matankaplyan-byte/MacroPad/macropad/macro_pad_BOM.csv

Reference | Value | Footprint | Exclude from Board | Exclude from Simulation | Qty | LCSC
C1 | 1uF | Capacitor_SMD:C_0603_1608Metric |  |  | 1 | C113807
C2,C3 | 1uF | C_0603_1608Metric |  |  | 2 | C113807
C4,C5,C6,C7,C8 | 100nf | C_0603_1608Metric |  |  | 5 | C49326605
C9,C10 | 33pF | C_0603_1608Metric |  |  | 2 | C107047
C11 | 100nF | C_0603_1608Metric |  |  | 1 | C49326605
J1 | USB_C_Receptacle_USB2.0_16P | Connector_USB:USB_C_Receptacle_HRO_TYPE-C-31-M-12 |  |  | 1 | C165948
J2 | Conn_01x07_Pin | Connector_PinHeader_2.54mm:PinHeader_1x07_P2.54mm_Vertical | Excluded from board |  | 1
R2,R3 | 5.1k | Resistor_SMD:R_0603_1608Metric |  |  | 2 | C23186
R4,R5 | 27Ω | Resistor_SMD:R_0603_1608Metric |  |  | 2 | C25190
R6,R7 | 10kΩ | Resistor_SMD:R_0603_1608Metric |  |  | 2 | C25804
SW1,SW4,SW5,SW6,SW7,SW8 | SW_Push | Button_Switch_Keyboard:SW_Cherry_MX_1.00u_PCB | Excluded from board |  | 6
SW2,SW3 | SW_Push | SW_SPST_TL3342 |  |  | 2 | C2886897
SW9 | RotaryEncoder_Switch | Rotary_Encoder:RotaryEncoder_Alps_EC11E-Switch_Vertical_H20mm |  |  | 1
U1 | RP2040 | Package_DFN_QFN:QFN-56-1EP_7x7mm_P0.4mm_EP3.2x3.2mm |  |  | 1 | C2040
U2 | AP2112K-3.3 | Package_TO_SOT_SMD:SOT-23-5 |  |  | 1 | C51118
U3 | GD25Q32ESIGR | Package_SO:SOIC-8_5.3x5.3mm_P1.27mm |  |  | 1 | C2832998
Y1 | 12MHz | Crystal:Crystal_SMD_3225-4Pin_3.2x2.5mm |  |  | 1 | C9002
