matankaplyan-byte/MacroPad/macropad/Top.step

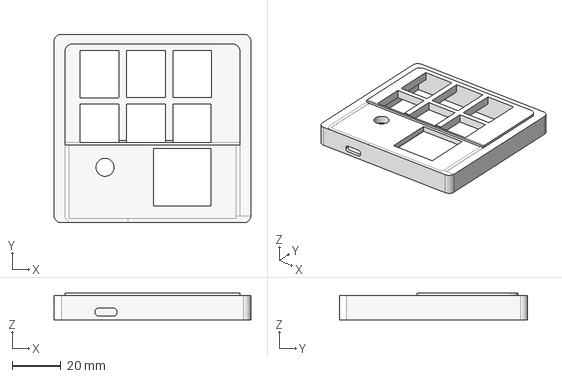
[picture p1: CAD file, 2026-11-11]
macropad/Top.step
80.7 x 77.2 x 11.0 mm
