matankaplyan-byte/MacroPad/macropad/Bottom.step

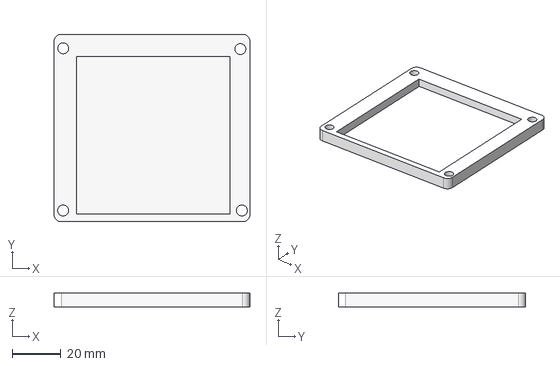
[picture p2: CAD file, 2026-11-11]
macropad/Bottom.step
80.7 x 77.2 x 5.80 mm
