matankaplyan-byte/MacroPad/macropad/macropadV3.step

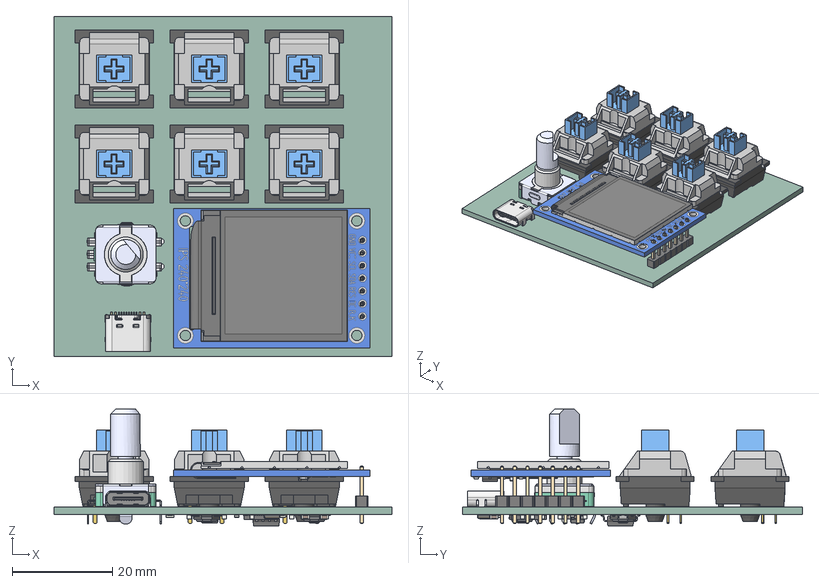
[picture p3: CAD file, 2026-11-11]
macropad/macropadV3.step
67.5 x 68.0 x 23.3 mm
PinHeader_1x07_P2.54mm_Vertical
1.3 TFT IPS - Board
1.3 TFT IPS - Flush Reverse Mount
0603 Resistor x 3
0603 Capacitor
SOT-23
Button x 6
Pins x 6
EC11-Base
EC11-Shaft-F
EC11-Housing-THT
ConPins
PcbPins
Mold
Frame
R_0603_1608Metric x 6
C_0603_1608Metric x 11
Crystal_SMD_3225-4Pin_3.2x2.5mm
SOT-23-5
SOIC-8_5.3x5.3mm_P1.27mm
SW_SPST_TL3342 x 2
QFN-56-1EP_7x7mm_P0.4mm_EP3.2x3.2mm
pcb_PCB
