matankaplyan-byte/MacroPad/macropad/pcb.kicad_pcb

## KiCad design macropad/pcb.kicad_pcb (2026-11-14)

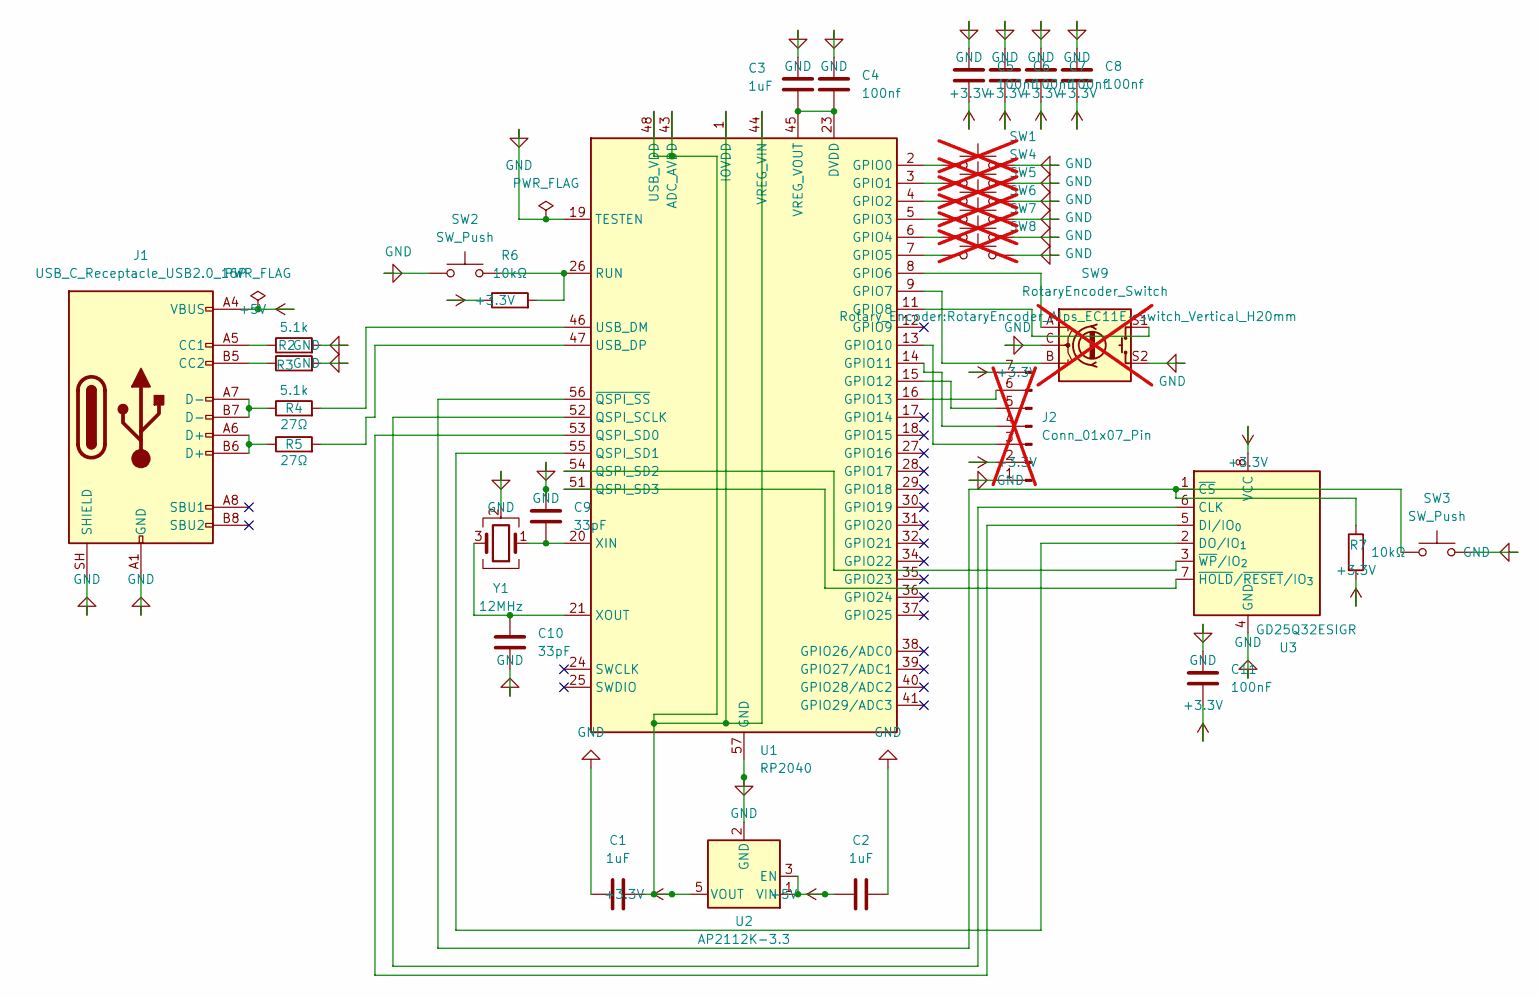
[picture p4: schematic pcb.kicad_sch]

Parts:
C1, C2, C3: 1uF; C_0603_1608Metric; LCSC C113807
C4, C5, C6, C7, C8: 100nf; C_0603_1608Metric; LCSC C49326065
C9, C10: 33pF; C_0603_1608Metric; LCSC C107047
C11: 100nF; C_0603_1608Metric; LCSC C49326065
J1: USB_C_Receptacle_USB2.0_16P; USB_C_Receptacle_HRO_TYPE-C-31-M-12; LCSC C165948
J2: Conn_01x07_Pin; PinHeader_1x07_P2.54mm_Vertical; not fitted
R2, R3: 5.1k; R_0603_1608Metric; LCSC C23186
R4, R5: 27Ω; R_0603_1608Metric; LCSC C25190
R6, R7: 10kΩ; R_0603_1608Metric; LCSC C25804
SW1, SW4, SW5, SW6, SW7, SW8: SW_Push; SW_Cherry_MX_1.00u_PCB; not fitted
SW2, SW3: SW_Push; SW_SPST_TL3342; LCSC C2886897
SW9: RotaryEncoder_Switch; RotaryEncoder_Alps_EC11E-Switch_Vertical_H20mm; not fitted
U1: RP2040; QFN-56-1EP_7x7mm_P0.4mm_EP3.2x3.2mm; LCSC C2040
U2: AP2112K-3.3; SOT-23-5; LCSC C51118
U3: GD25Q32ESIGR; SOIC-8_5.3x5.3mm_P1.27mm; LCSC C2832998
Y1: 12MHz; Crystal_SMD_3225-4Pin_3.2x2.5mm; LCSC C9002

Connections:
+3.3V: C1.2, C5.2, C6.2, C7.2, C8.2, C11.1, J2.2, J2.7, R6.1, R7.2, U1.1 (IOVDD), U1.10 (IOVDD), U1.22 (IOVDD), U1.33 (IOVDD), U1.42 (IOVDD), U1.43 (ADC_AVDD), U1.44 (VREG_VIN), U1.48 (USB_VDD), U1.49 (IOVDD), U2.5 (VOUT), U3.8 (VCC)
+5V: C2.1, J1.A4 (VBUS), J1.A9 (VBUS), J1.B4 (VBUS), J1.B9 (VBUS), U2.1 (VIN), U2.3 (EN)
GND: C1.1, C2.2, C3.1, C4.1, C5.1, C6.1, C7.1, C8.1, C9.1, C10.2, C11.2, J1.A1 (GND), J1.A12 (GND), J1.B1 (GND), J1.B12 (GND), J1.SH (SHIELD), J2.1, R2.2, R3.2, SW1.2, SW2.1, SW3.2, SW4.2, SW5.2, SW6.2, SW7.2, SW8.2, SW9.C, SW9.S2, U1.19 (TESTEN), U1.57 (GND), U2.2 (GND), U3.4 (GND), Y1.2 (G), Y1.4 (G)
unnamed: J1.A5 (CC1), R2.1
unnamed: J1.B5 (CC2), R3.1
unnamed: J1.A6 (D+), J1.B6 (D+), R5.1
unnamed: J1.A7 (D-), J1.B7 (D-), R4.1
unnamed: J2.3, U1.13 (GPIO10)
unnamed: J2.4, U1.14 (GPIO11)
unnamed: J2.5, U1.15 (GPIO12)
unnamed: J2.6, U1.16 (GPIO13)
unnamed: SW1.1, U1.2 (GPIO0)
unnamed: SW4.1, U1.3 (GPIO1)
unnamed: SW5.1, U1.4 (GPIO2)
unnamed: SW6.1, U1.5 (GPIO3)
unnamed: SW7.1, U1.6 (GPIO4)
unnamed: SW8.1, U1.7 (GPIO5)
unnamed: SW9.A, U1.8 (GPIO6)
unnamed: SW9.B, U1.9 (GPIO7)
unnamed: SW9.S1, U1.11 (GPIO8)
unnamed: U1.52 (QSPI_SCLK), U3.6 (CLK)
unnamed: U1.53 (QSPI_SD0), U3.5 (DI/IO_{0})
unnamed: U1.55 (QSPI_SD1), U3.2 (DO/IO_{1})
unnamed: U1.54 (QSPI_SD2), U3.3 (~WP/IO_{2})
unnamed: U1.51 (QSPI_SD3), U3.7 (~HOLD/~RESET/IO_{3})
unnamed: R6.2, SW2.2, U1.26 (RUN)
unnamed: R4.2, U1.46 (USB_DM)
unnamed: R5.2, U1.47 (USB_DP)
unnamed: C3.2, C4.2, U1.23 (DVDD), U1.45 (VREG_VOUT), U1.50 (DVDD)
unnamed: C9.2, U1.20 (XIN), Y1.1
unnamed: C10.1, U1.21 (XOUT), Y1.3
unnamed: R7.1, SW3.1, U1.56 (~QSPI_SS), U3.1 (~CS)

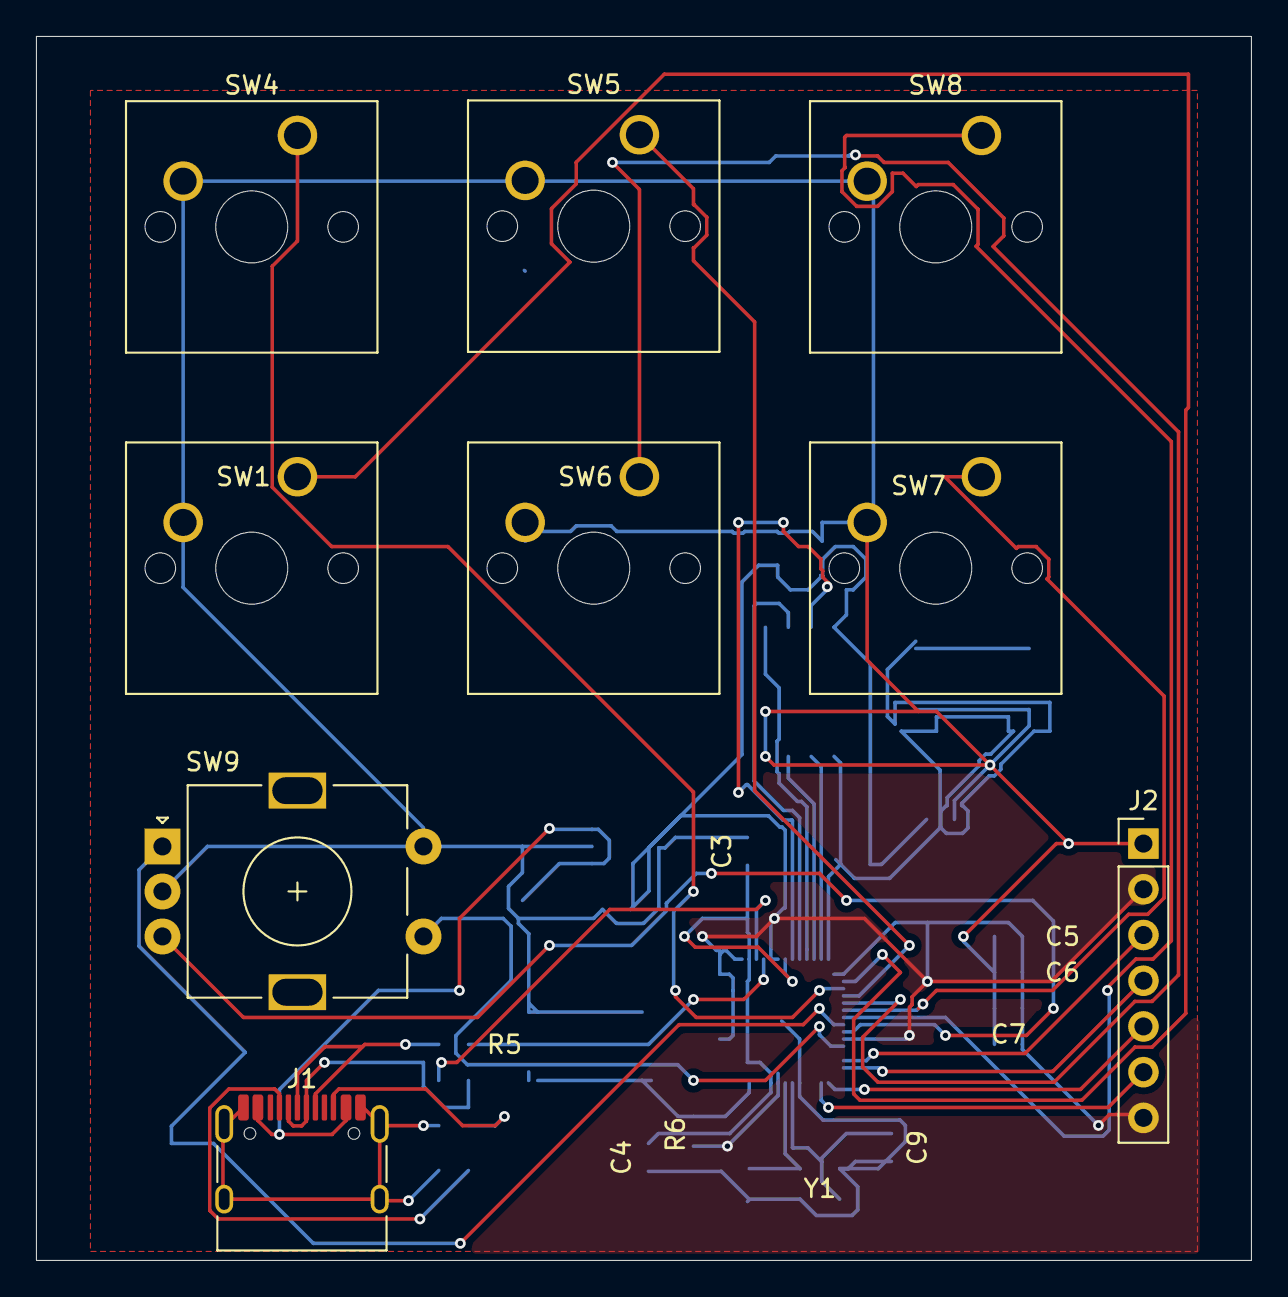
[picture p5: board pcb.kicad_pcb from above]

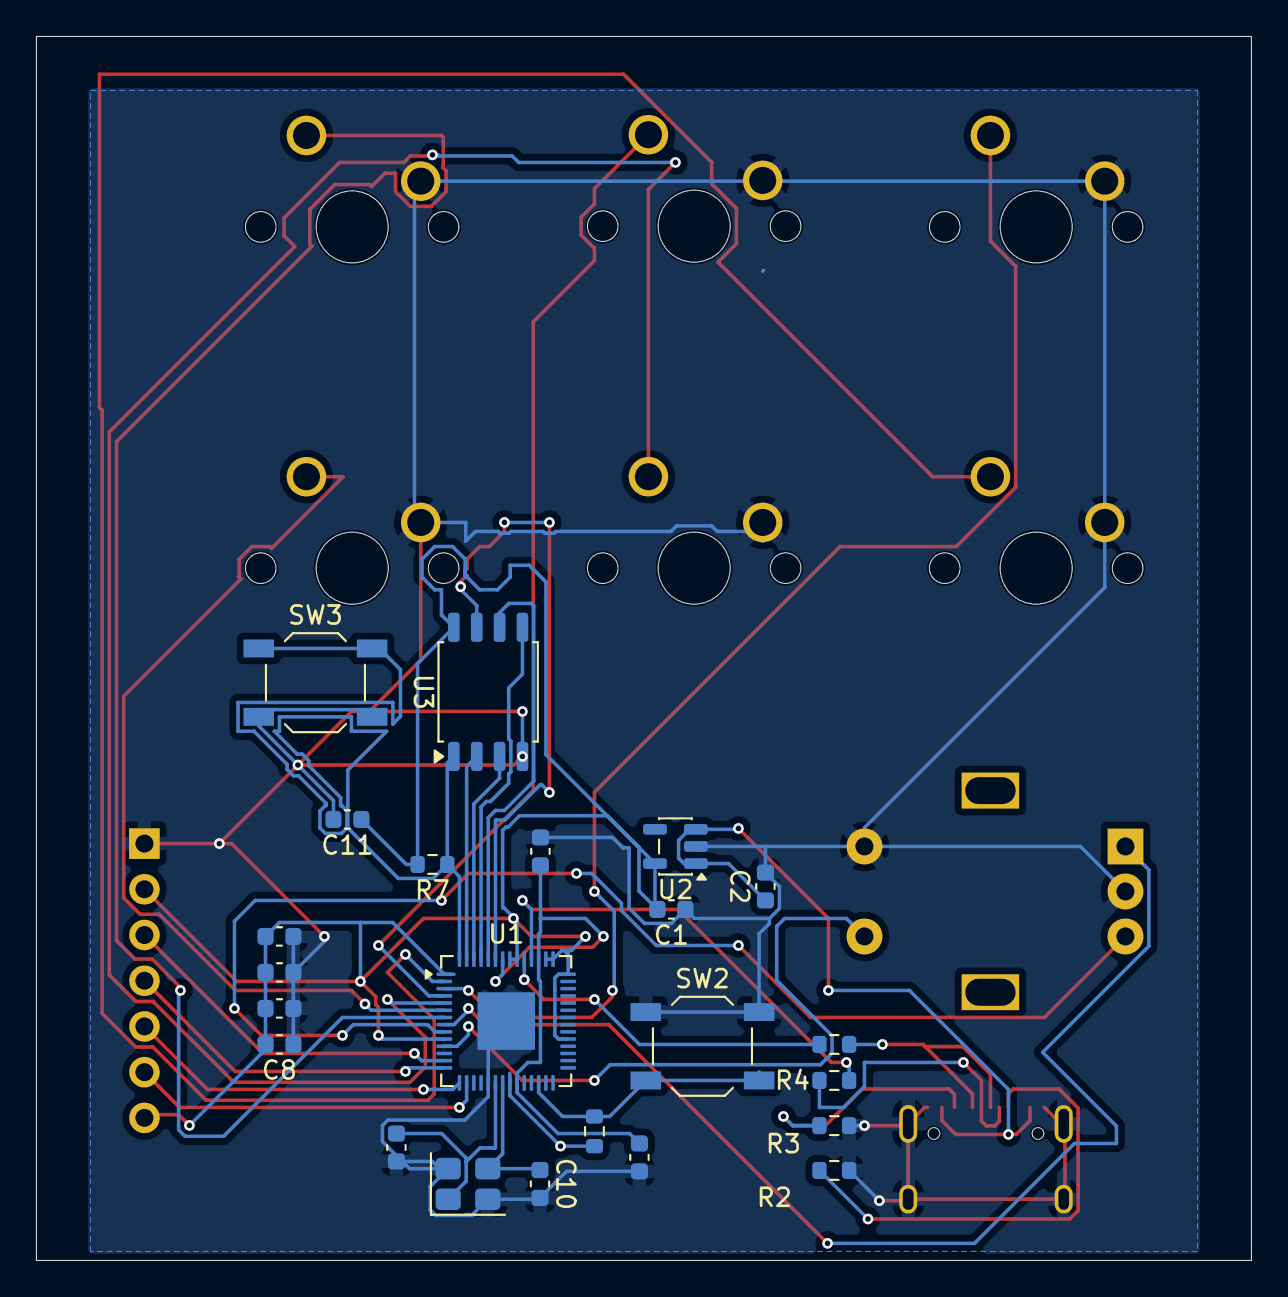
[picture p6: board pcb.kicad_pcb from below]

Board: 2 copper layers, 67.5 x 68.0 mm, 32 parts (23 on the bottom side), 32 nets.
